alexeyreutov/esp32-flashforge-watch/enclosure/FlashforgeWatch.step

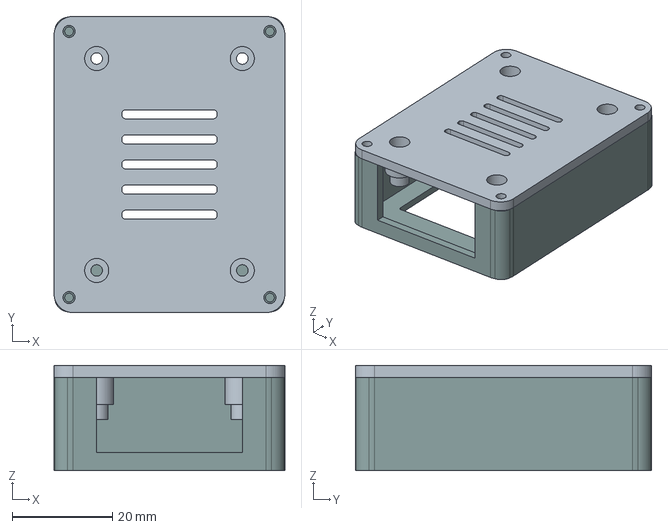
[picture p1: CAD file, 2026-11-13]
enclosure/FlashforgeWatch.step
46.0 x 59.0 x 21.0 mm
Front
Rear
