alexeyreutov/esp32-flashforge-watch/enclosure/rear.stl

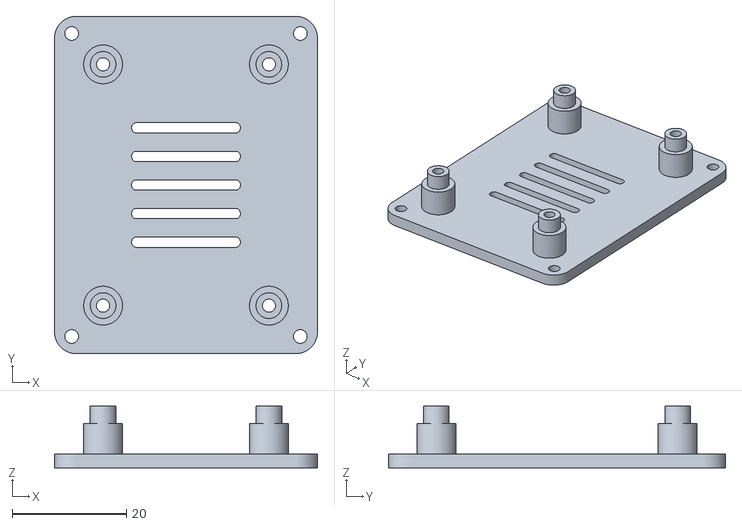
[picture p2: CAD file, 2026-11-13]
enclosure/rear.stl
46.0 x 59.0 x 10.8
