alexeyreutov/esp32-flashforge-watch/enclosure/front.stl

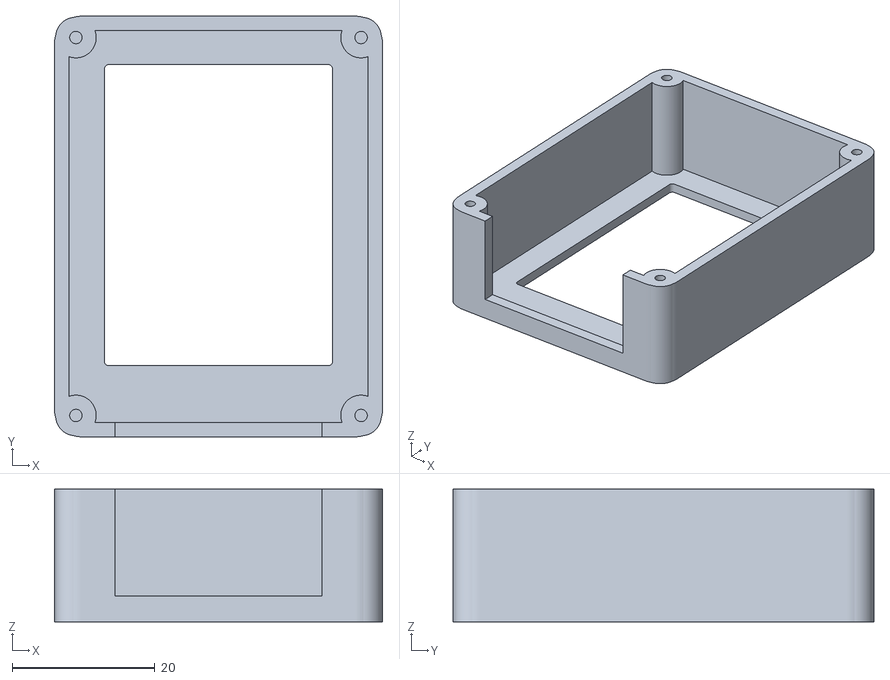
[picture p3: CAD file, 2026-11-13]
enclosure/front.stl
46.0 x 59.0 x 18.6
