alexeyreutov/esp32-flashforge-watch/(commit log)

2026-11-13 Add ESP32 Flashforge print monitor and Waveshare LCD firmware
2026-11-13 Add printable Waveshare LCD-2 enclosure and assembly instructions
    [FlashforgeWatch.step, front.stl, rear.stl]
2026-11-13 Adapt enclosure to eight M2x6 low-profile screws
    [FlashforgeWatch.step, rear.stl]
2026-11-13 Report printer status request failures on the monitor
    [flashforge_watch.ino]
2026-11-13 Show fullscreen camera with progress and ETA and prefill web settings
2026-11-13 Keep web settings responsive during printer polling
2026-11-13 Verify web settings writes and avoid redrawing unchanged LCD status
    [flashforge_watch.ino, lcd.h]
